yuvrajruparel/Spiderbot/assembly.stl

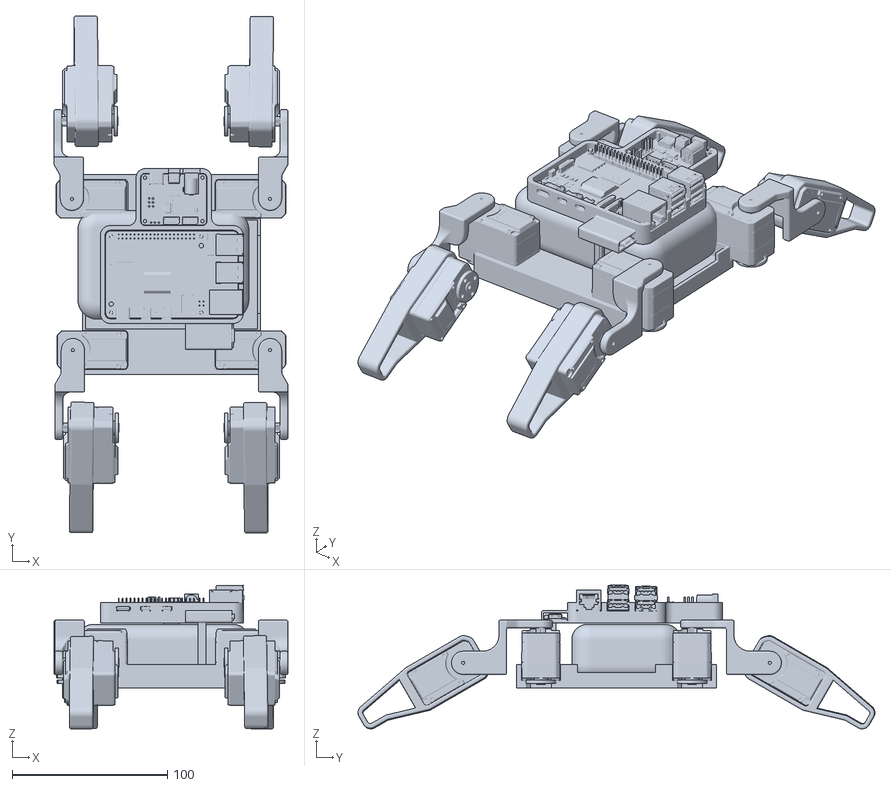
[picture p1: CAD file, 2026-09-22]
assembly.stl
150.5 x 332.6 x 92.5
