yuvrajruparel/Spiderbot/assets/leg_lower_R.stl

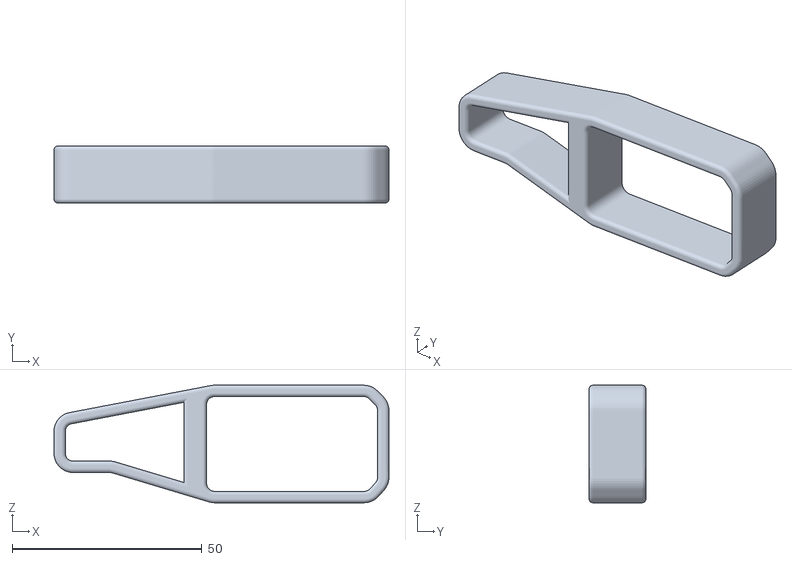
[picture p2: CAD file, 2026-09-22]
assets/leg_lower_R.stl
88.3 x 15.0 x 31.0
