yuvrajruparel/Spiderbot/assets/leg_upper_L.stl

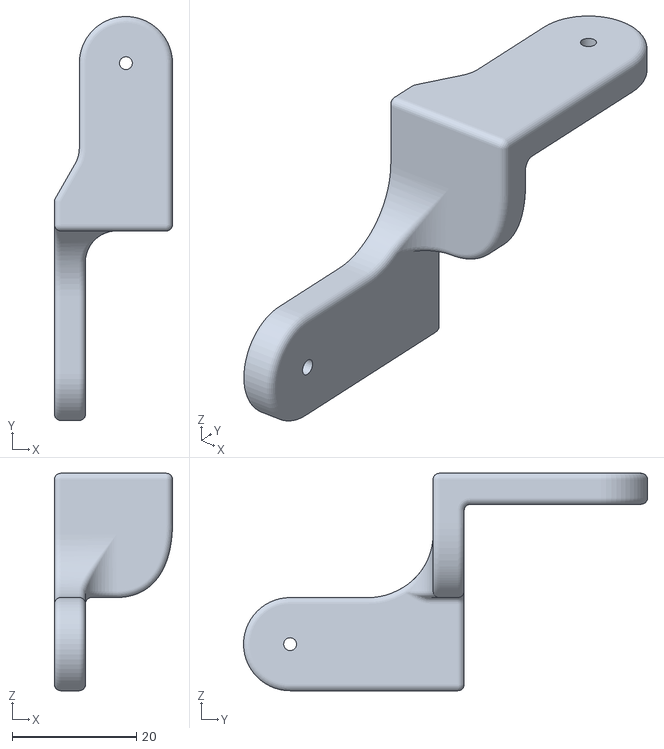
[picture p3: CAD file, 2026-09-22]
assets/leg_upper_L.stl
19.0 x 65.0 x 35.0
