yuvrajruparel/Spiderbot/assets/chassis.stl

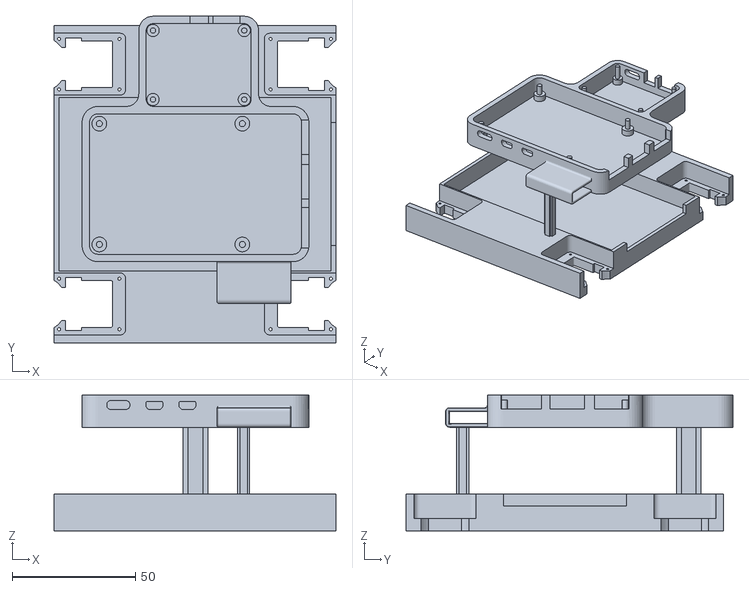
[picture p4: CAD file, 2026-09-22]
assets/chassis.stl
114.4 x 132.5 x 55.0
