yuvrajruparel/Spiderbot/(list of files, cad)

Other CAD files:
assets/leg_lower_L.stl
assets/leg_upper_R.stl
