yuvrajruparel/Spiderbot/GRL.pdf

1 mm二武 | 乎≤☆…… Powerbank

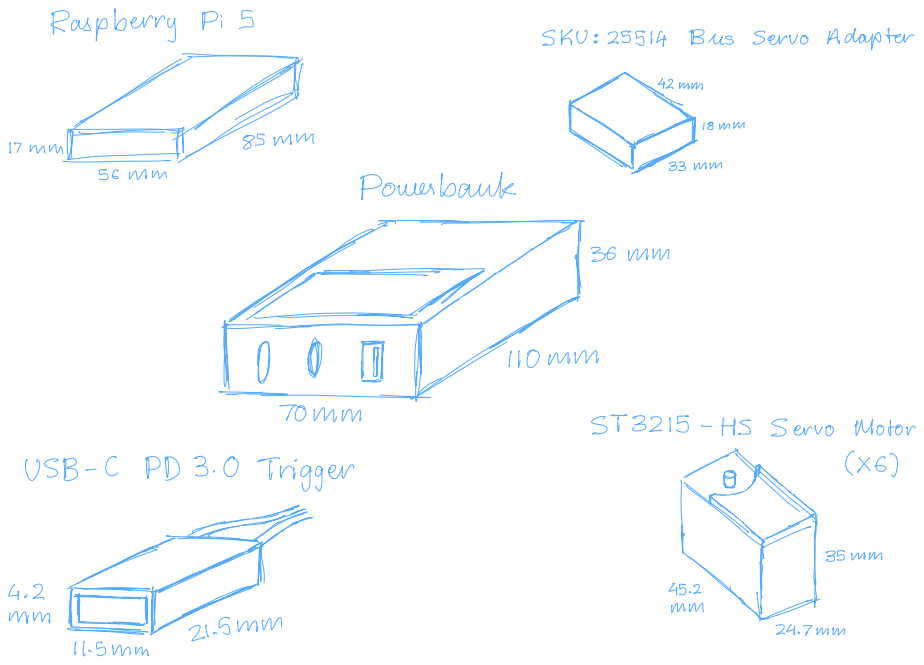
[picture p5: page 1]
SKU : 25514; Bus Servo; Adapter; ≡☆soum110mms; ST3215-HS Servo Motor; USB-C PD 3.0 Trigger; ismm; 靭翔器nnuq

# sketch Spidubot

# -unmovable rear legs n

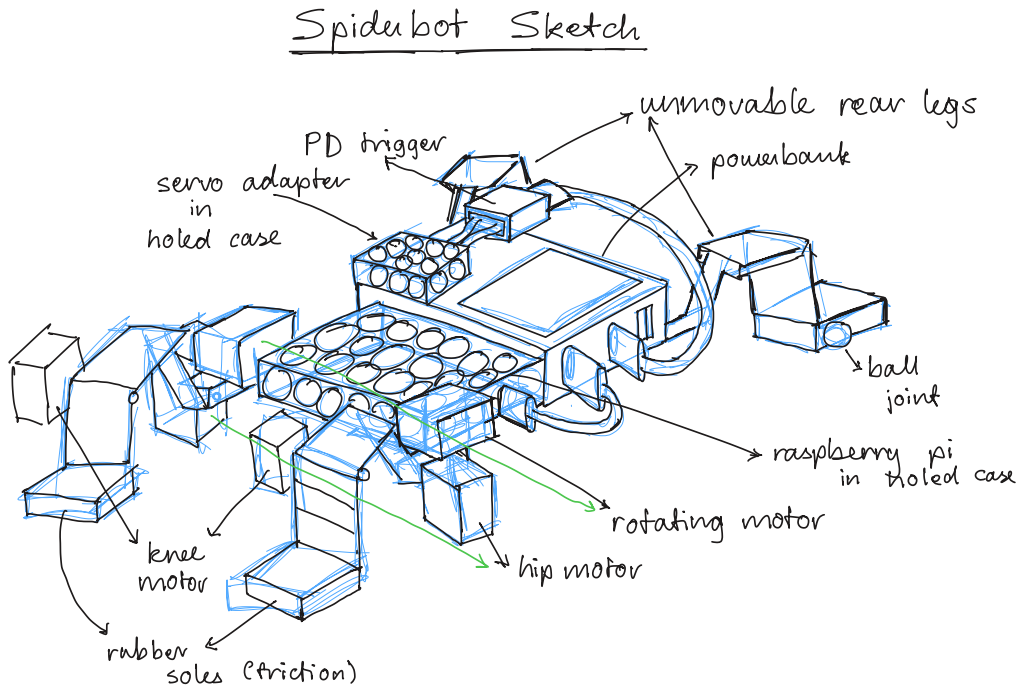
[picture p6: page 2]
PD trigger; powerbank; servo; adapter; holed case; ↳ ball 808800000000 pi; joint; otating motor; hip motor

in holed case

た率

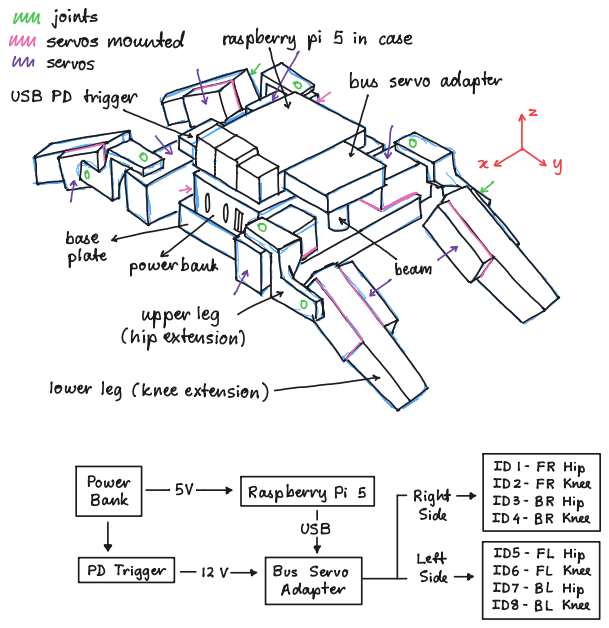
[picture p7: page 3]
m joints; un servosmounted; raspberry pi 5 in case; ㎡ servos; Chip; extension); FR Hip; Raspberry Pis; Right; ID최 ⁻; BR Hip ㅖ; B R Knee; Left; Hip; PD Trigger; Bus Servo; Side; FL Knee; Adapter; 吕 ∠ Hip; ID8- 1 Knee

bus servo adapter

lower leg (knee extension)

FR Knee Power-5⁻>
